CurioDev/CurioBase/BOM.md

# Curio Bill of Materials (BOM)

| # | Component | Est. Cost | Link
|---|---|---| ----
| 1 | MDBT42Q Bluetooth Module | £12 | [Link](https://shop.espruino.com/mdbt42q/mdbt42q-module)
| 2 | Stepper Motors | ~£5 | [Link](https://amzn.eu/d/4aenMIB)
| 3 | LiPo Battery (3.7V, 400mAh) | ~£5 | [Link](https://kitronik.co.uk/products/2209-polymer-lithium-ion-battery-37v-400mah)
| 4 | Body / Wheels | ~£15 |
| 5 | Wires / Screws / Hardware | ~£3 |

---

### 💷 Estimated Total Cost is **£40**
