CurioDev/CurioBase/v1/notes.txt

3mm birch laser ply (poplar isn't strong enough)
Wheels: FS-90RW-C001 / https://www.rapidonline.com/feetech-wheel-for-use-with-fs90r-servo-servo-not-included-37-1338
Steppers: 28BYJ-48
JST cable
9V battery clip

Recent requests
---------------

Move battery bolt hole inwards to align
X Needs to go faster
X Put degree markings on the rotation points
X Put A/B/C markings on the rotation points. All markings to be on the inside to people can put stickers/customize the outside. Let's do:
  A for 0° (Vertical)
  B for 20° (5th crank)
  C for 45° (10th crank)
  D for 65° (14th crank)
  E for 90° (horizontal)
X Have only bottom and top tabs, which are single indents.
X Add another 10mm to the width
X Move battery to middle, hold in place with zip tie
X Make battery charge side hole generously big so most sorts of "USB cable head" can fit in. 
X Make handles adjusting the reclining position more visible (stick out more, colour them red)
X Raise the phone holder up a little (floor clearance + lying flat) - 5mm higher, 3mm forward
X Put perspex circle around the phone holder pivots to strengthen them
X Ensure there's clearance to get the phone 100% vertical
X On/Off button on board + LED indication
X Hiding cables and control board/PCB
X 90mm max phone width
X phone held in with elastic bands
X custom driver board

Mk.1 notes
-----------

FIXED - Wheel cutout needs to be ~4.8 x 2.7mm 
FIXED - Stepper wheels too small - wires touch the ground
FIXED - Stepper wheels really need rubber/something - so either use rubber wheels or o-ring+3x sheets of ply
FIXED - cutout on faceplate for camera?
Do the sides flex too much? Do they need an elastic band or some kind of support?

Mk. 2 notes
-----------

FIXED Can we get it properly 90 degrees? Move/take down the baseplate by 1mm
FIXED 0.5mm less travel for the bendy clip in the phone holder - can stretch it too far
FIXED Strengthen clip - maybe make it longer, make solid part at end bigger
FIXED Phone holder could be a bit less wide at the bottom to make the rubber band easier to access
