CurioDev/CurioBase/v2/gen/bot.stl

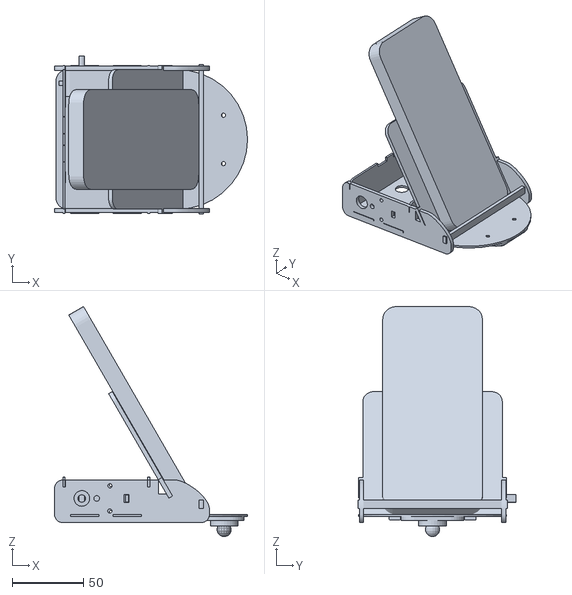
[picture p1: CAD file, 2024-03-22]
v2/gen/bot.stl
135.7 x 111.2 x 161.6
