CurioDev/CurioBase/v2/objs/wheel.stl

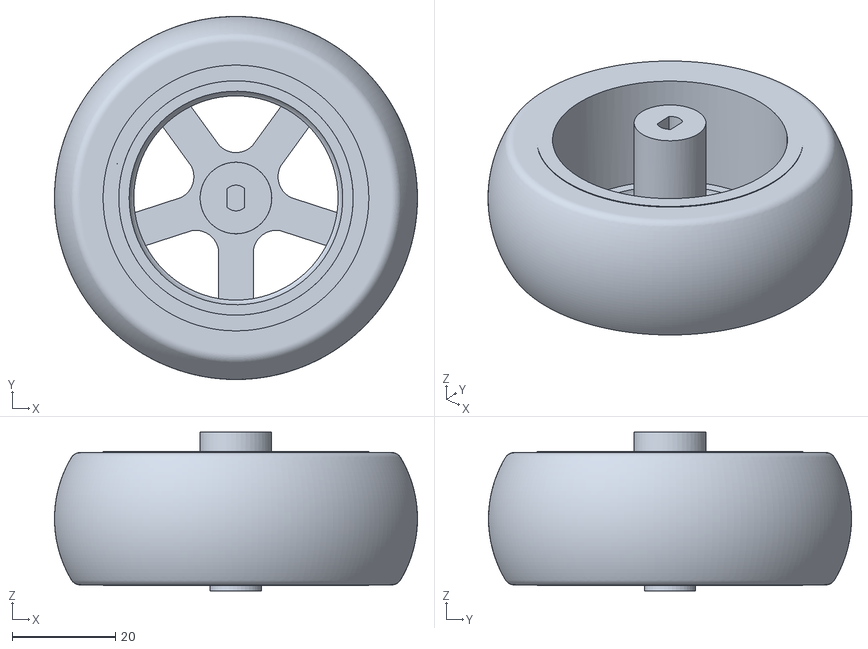
[picture p2: CAD file, 2024-03-22]
v2/objs/wheel.stl
70.5 x 70.5 x 30.8
