CurioDev/CurioBase/v2/objs/motor-tt.stl

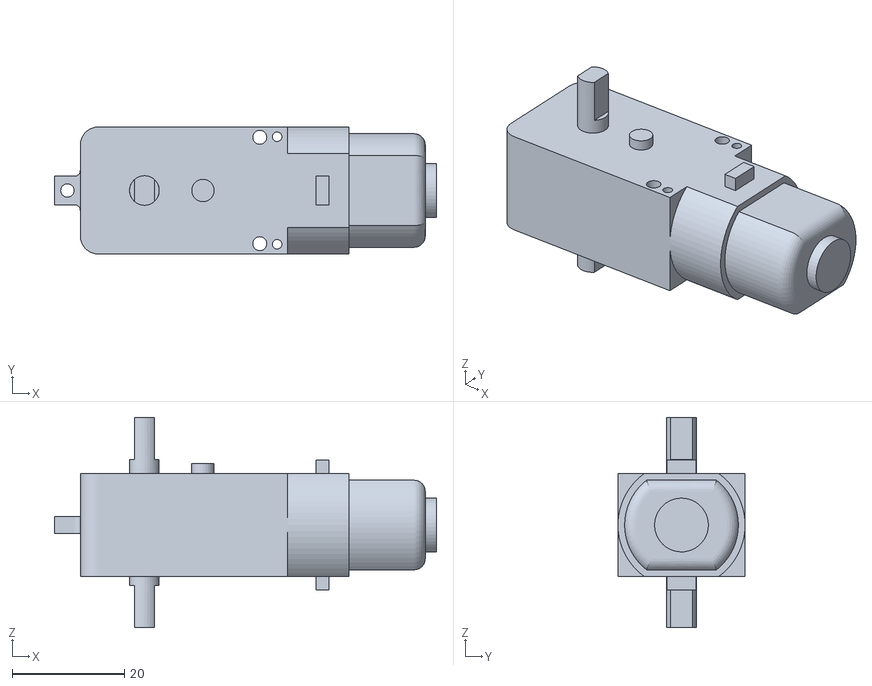
[picture p3: CAD file, 2024-03-22]
v2/objs/motor-tt.stl
68.2 x 22.7 x 37.5
