CurioDev/CurioBase/v1/bot_complete_acrylic.dxf

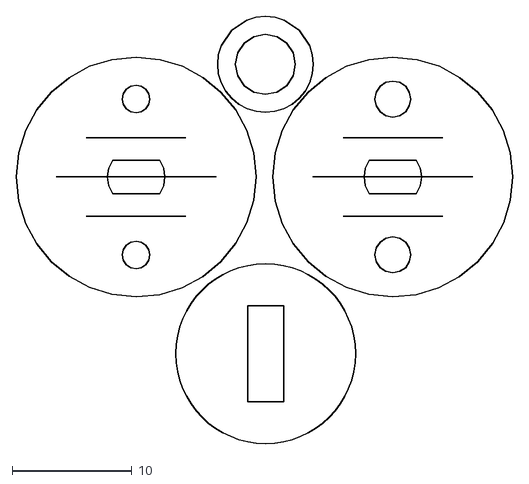
[picture p4: CAD file, 2024-03-22, an earlier design]
v1/bot_complete_acrylic.dxf
41.4 x 35.6
