CurioDev/CurioBase/v1/bot_complete_wood_mod.dxf

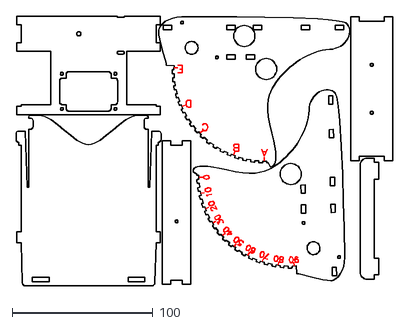
[picture p5: CAD file, 2024-03-22, an earlier design]
v1/bot_complete_wood_mod.dxf
267.6 x 191.5
