CurioDev/CurioBase/v1/bot_complete_wood.dxf

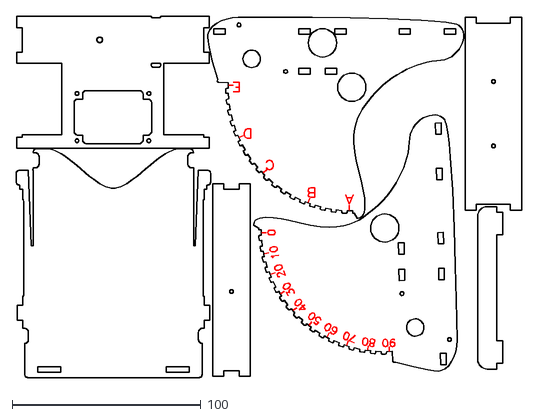
[picture p6: CAD file, 2024-03-22, an earlier design]
v1/bot_complete_wood.dxf
267.7 x 191.4
