CurioDev/CurioBase/v1/bot_wheel_mount.dxf

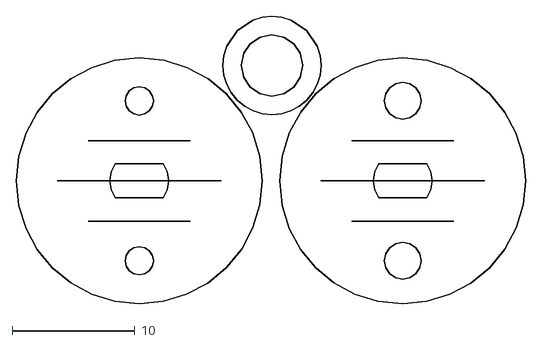
[picture p7: CAD file, 2024-03-22, an earlier design]
v1/bot_wheel_mount.dxf
41.4 x 23.4
