CurioDev/CurioBase/v1/gen/bot_flat.stl

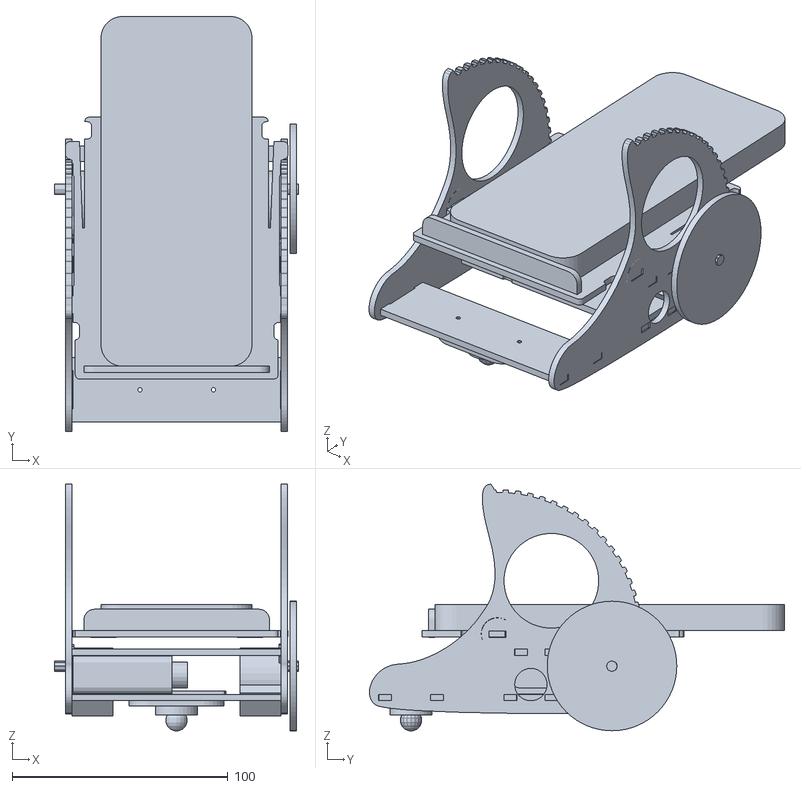
[picture p8: CAD file, 2023-06-23, an earlier design]
v1/gen/bot_flat.stl
113.0 x 192.3 x 114.2
