CurioDev/CurioBase/v1/gen/bot_angled.stl

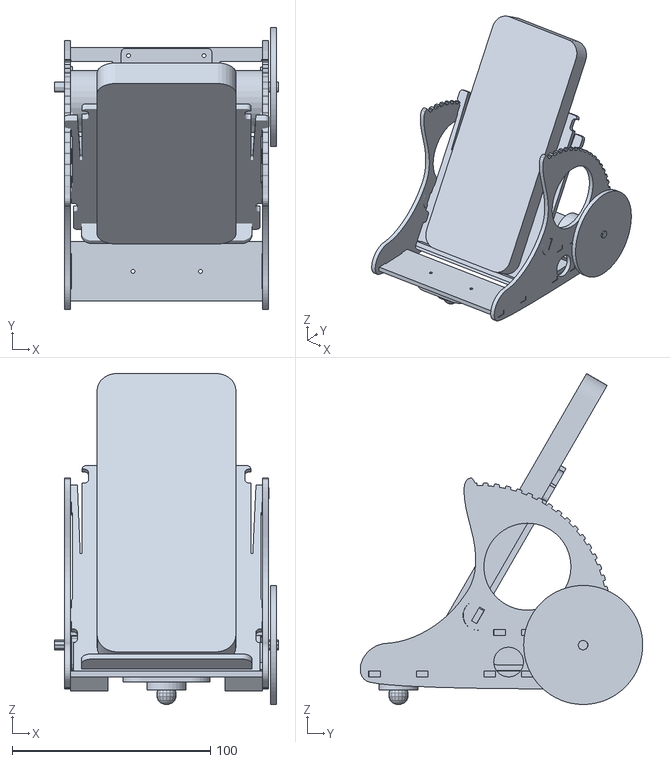
[picture p9: CAD file, 2023-06-23, an earlier design]
v1/gen/bot_angled.stl
113.0 x 142.4 x 166.8
