CurioDev/CurioBase/v1/gen/bot_upright.stl

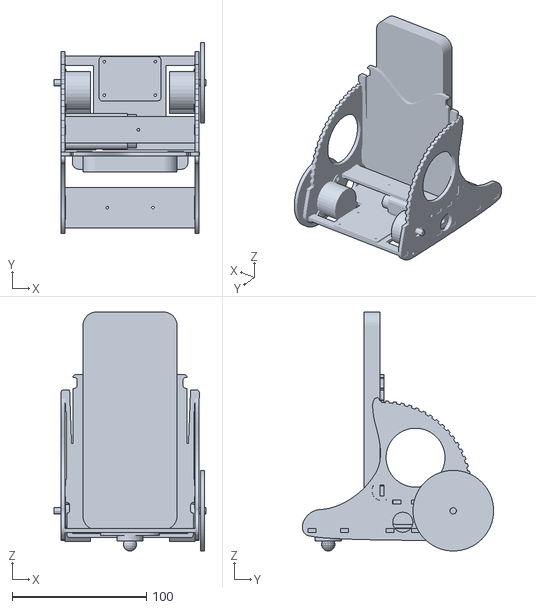
[picture p10: CAD file, 2023-06-23, an earlier design]
v1/gen/bot_upright.stl
113.0 x 142.4 x 177.9
