CurioDev/CurioBase/v1/bot_castorholder.dxf

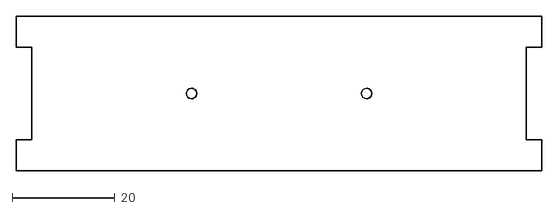
[picture p11: CAD file, 2024-03-22, an earlier design]
v1/bot_castorholder.dxf
102.0 x 30.0
