CurioDev/CurioBase/v1/bot_side.dxf

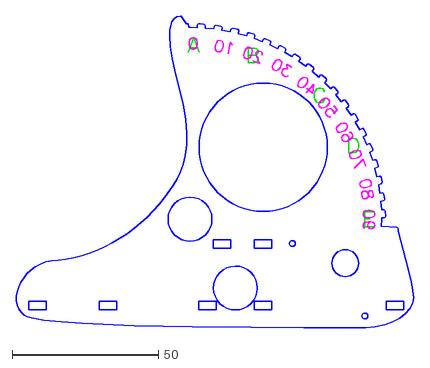
[picture p12: CAD file, 2023-05-22, an earlier design]
v1/bot_side.dxf
135.6 x 106.3
