CurioDev/CurioBase/v1/bot_baseplate.dxf

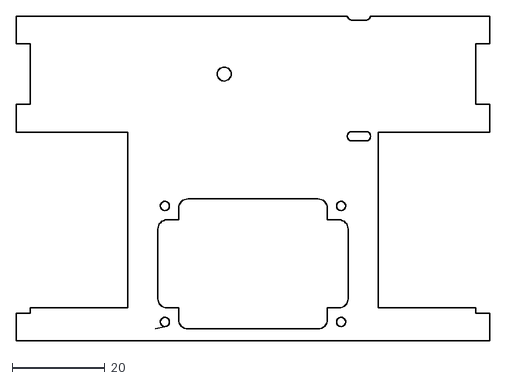
[picture p13: CAD file, 2023-05-22, an earlier design]
v1/bot_baseplate.dxf
102.0 x 70.0
