CurioDev/CurioBase/v1/bot_topplate.dxf

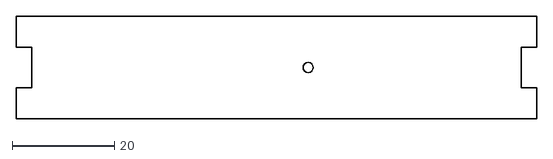
[picture p14: CAD file, 2023-05-22, an earlier design]
v1/bot_topplate.dxf
102.0 x 20.0
