CurioDev/CurioBase/v1/bot_phoneholder.dxf

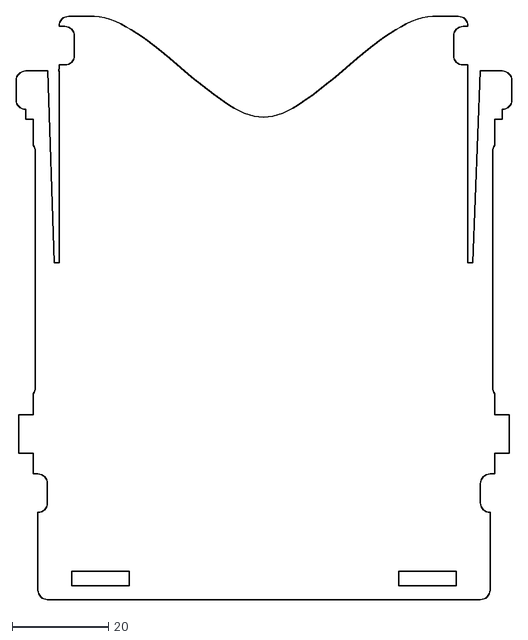
[picture p15: CAD file, 2023-05-22, an earlier design]
v1/bot_phoneholder.dxf
103.0 x 121.2
