CurioDev/CurioBase/v1/bot_phonebase.dxf

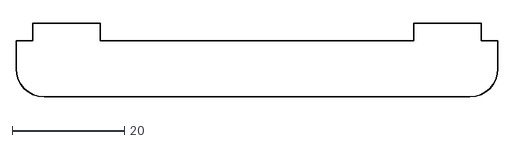
[picture p16: CAD file, 2023-05-03, an earlier design]
v1/bot_phonebase.dxf
86.0 x 13.1
