CurioDev/CurioBase/v1/bot_phone_axle.dxf

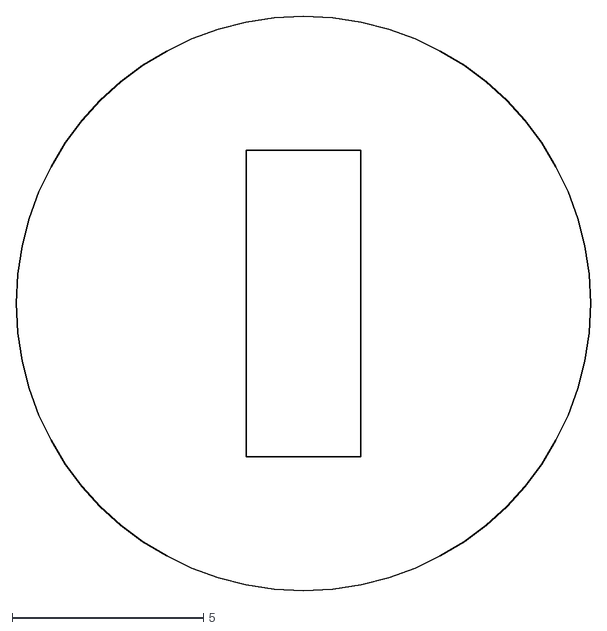
[picture p17: CAD file, 2023-03-31, an earlier design]
v1/bot_phone_axle.dxf
15.0 x 15.0
