CurioDev/CurioBase/v1/bot_wheel.dxf

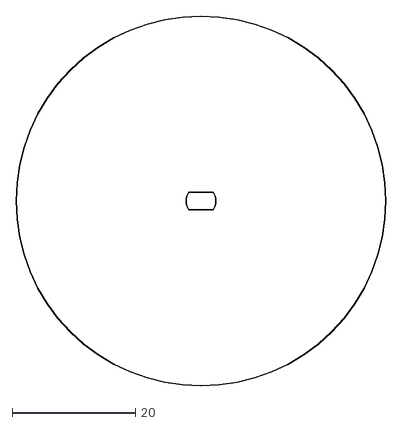
[picture p18: CAD file, 2023-02-08, an earlier design]
v1/bot_wheel.dxf
60.0 x 60.0
