CurioDev/CurioBase/(list of files, cad)

Other CAD files:
v1/bot.scad
