CurioDev/CurioBase/v2/sch/bot_base.brd

## EAGLE design v2/sch/bot_base.brd (2024-07-25)

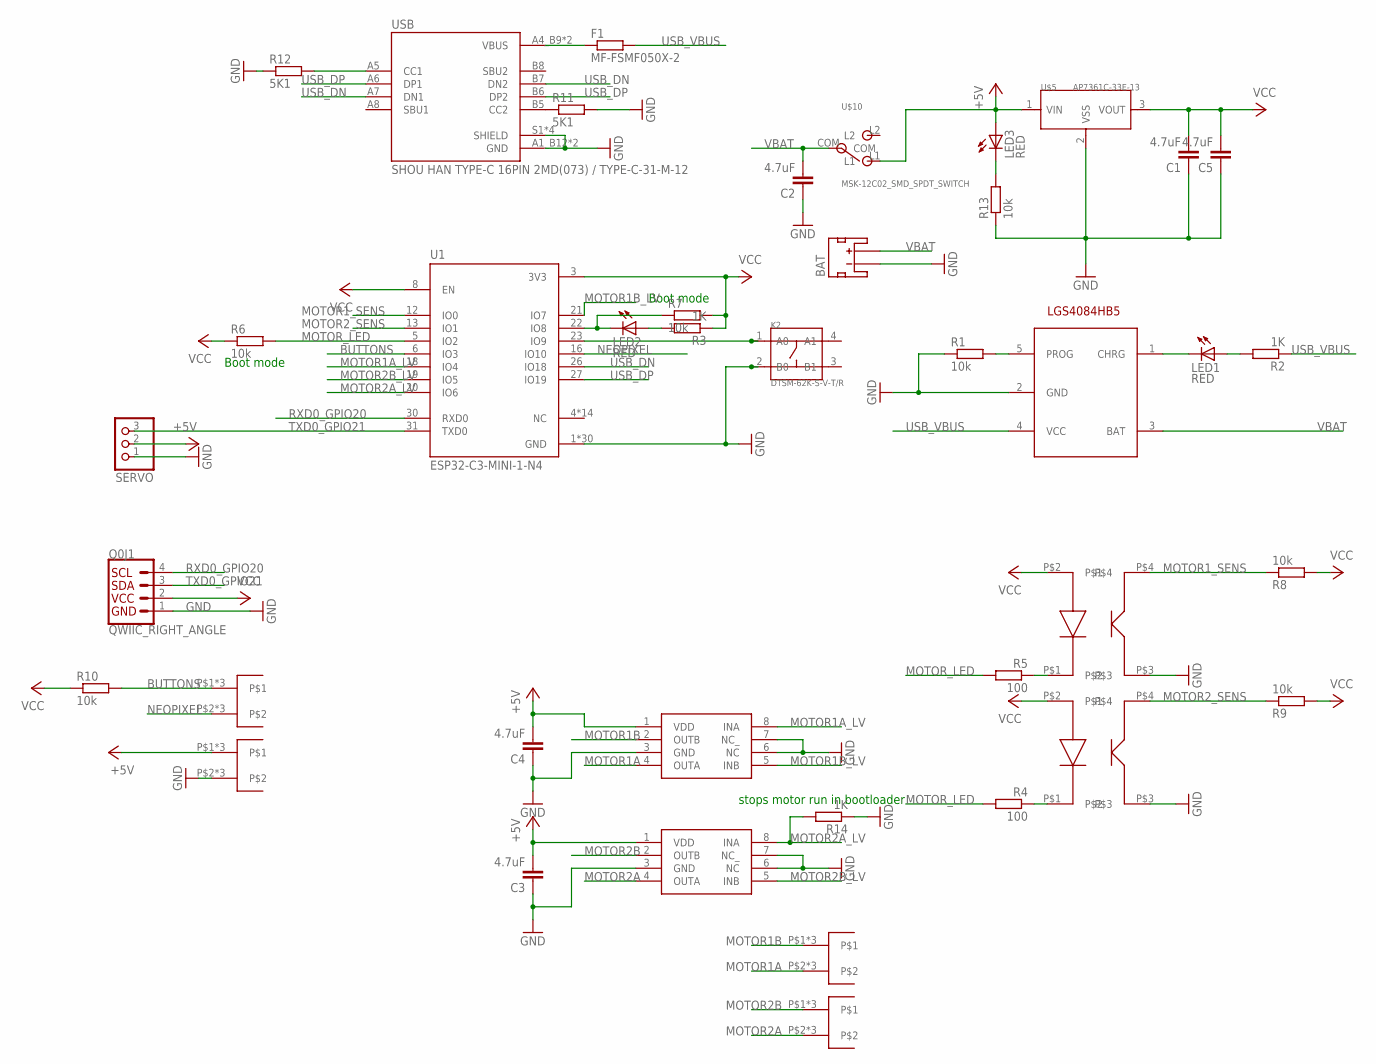
[picture p19: schematic bot_base.sch]

Parts:
BAT: C47647 / S2B-PH-SM4-TB; JST-2-SMD
C1, C2, C3, C4, C5: 4.7uF; C0805
F1: MF-FSMF050X-2; R0603
K2: DTSM-62K-S-V-T/R; SW4-SMD-6.0X6.0X5.0MM
LED1, LED2, LED3: RED; CHIPLED_0603
Q0: QWIIC_RIGHT_ANGLE; JST04_1MM_RA
R1, R6, R7, R8, R9, R10, R13: 10k; R0603
R2, R3, R14: 1K; R0603
R4, R5: 100; R0603
R11, R12: 5K1; R0603
SERVO: PINHD-1X03_2.54-S; 1X03-S
U1: ESP32-C3-MINI-1-N4; XCVR_ESP32-C3-MINI-1-N4
U4: LGS4084HB5; SOT23-5
U$1, U$2: XL-ITR9707
U$3, U$4: GR6205; SOP8
U$5: AP7361C-33E-13; SOT223
U$6, U$7, U$8, U$9: PCBSIDE2
U$10: MSK-12C02_SMD_SPDT_SWITCH; MSK-12C02
USB: SHOU HAN TYPE-C 16PIN 2MD(073) / TYPE-C-31-M-12; HRO_TYPE-C-31-M-12

Connections:
+5V: C3.2, C4.2, LED3.A, SERVO.2, U$3.1 (VDD), U$4.1 (VDD), U$5.1 (VIN), U$9.P$1, U$9.P$3, U$9.P$4, U$10.L1
BOOT: K2.1 (A0), U1.23 (IO9)
BUTTONS: R10.2, U1.6 (IO3), U$8.P$1, U$8.P$3, U$8.P$4
GND: BAT.1 (-), C1.1, C2.1, C3.1, C4.1, C5.1, K2.2 (B0), Q0.1, R1.1, R11.2, R12.1, R13.1, R14.1, SERVO.1, U1.1 (GND), U1.2 (GND), U1.11 (GND), U1.14 (GND), U1.36 (GND), U1.37 (GND), U1.38 (GND), U1.39 (GND), U1.40 (GND), U1.41 (GND), U1.42 (GND), U1.43 (GND), U1.44 (GND), U1.45 (GND), U1.46 (GND), U1.47 (GND), U1.48 (GND), U1.49_1 (GND), U1.49_2 (GND), U1.49_3 (GND), U1.49_4 (GND), U1.49_5 (GND), U1.49_6 (GND), U1.49_7 (GND), U1.49_8 (GND), U1.49_9 (GND), U1.50 (GND), U1.51 (GND), U1.52 (GND), U1.53 (GND), U4.2 (GND), U$1.P$3, U$2.P$3, U$3.3 (GND), U$3.6 (NC), U$3.7 (NC_), U$4.3 (GND), U$4.6 (NC), U$4.7 (NC_), U$5.2 (VSS), U$9.P$2, U$9.P$5, U$9.P$6, USB.A1_B12 (GND), USB.B1_A12 (GND), USB.S1 (SHIELD), USB.S2 (SHIELD), USB.S3 (SHIELD), USB.S4 (SHIELD)
MOTOR1A: U$3.4 (OUTA), U$6.P$2, U$6.P$5, U$6.P$6
MOTOR1A_LV: U1.18 (IO4), U$3.8 (INA)
MOTOR1B: U$3.2 (OUTB), U$6.P$1, U$6.P$3, U$6.P$4
MOTOR1B_LV: U1.21 (IO7), U$3.5 (INB)
MOTOR1_SENS: R8.1, U1.12 (IO0), U$1.P$4
MOTOR2A: U$4.4 (OUTA), U$7.P$2, U$7.P$5, U$7.P$6
MOTOR2A_LV: R14.2, U1.20 (IO6), U$4.8 (INA)
MOTOR2B: U$4.2 (OUTB), U$7.P$1, U$7.P$3, U$7.P$4
MOTOR2B_LV: U1.19 (IO5), U$4.5 (INB)
MOTOR2_SENS: R9.1, U1.13 (IO1), U$2.P$4
MOTOR_LED: R4.2, R5.2, R6.2, U1.5 (IO2)
unnamed: LED1.C, U4.1 (CHRG)
unnamed: LED3.C, R13.2
unnamed: R5.1, U$1.P$1
unnamed: LED1.A, R2.2
unnamed: R4.1, U$2.P$1
unnamed: LED2.A, R3.2
unnamed: R11.1, USB.B5 (CC2)
unnamed: LED2.C, R7.1, U1.22 (IO8)
unnamed: R12.2, USB.A5 (CC1)
unnamed: R1.2, U4.5 (PROG)
NEOPIXEL: U1.16 (IO10), U$8.P$2, U$8.P$5, U$8.P$6
RXD0_GPIO20: Q0.4, U1.30 (RXD0)
TXD0_GPIO21: Q0.3, SERVO.3, U1.31 (TXD0)
USB_DN: U1.26 (IO18), USB.A7 (DN1), USB.B7 (DN2)
USB_DP: U1.27 (IO19), USB.A6 (DP1), USB.B6 (DP2)
USB_VBUS: F1.2, R2.1, U4.4 (VCC)
VBAT: BAT.2 (+), C2.2, U4.3 (BAT), U$10.COM
VBUS1: F1.1, USB.A4_B9 (VBUS), USB.B4_A9 (VBUS)
VCC: C1.2, C5.2, Q0.2, R3.1, R6.1, R7.2, R8.2, R9.2, R10.1, U1.3 (3V3), U1.8 (EN), U$1.P$2, U$2.P$2, U$5.3 (VOUT)

Notes on the sheet:
LGS4084HB5
Boot mode
stops motor run in bootloader

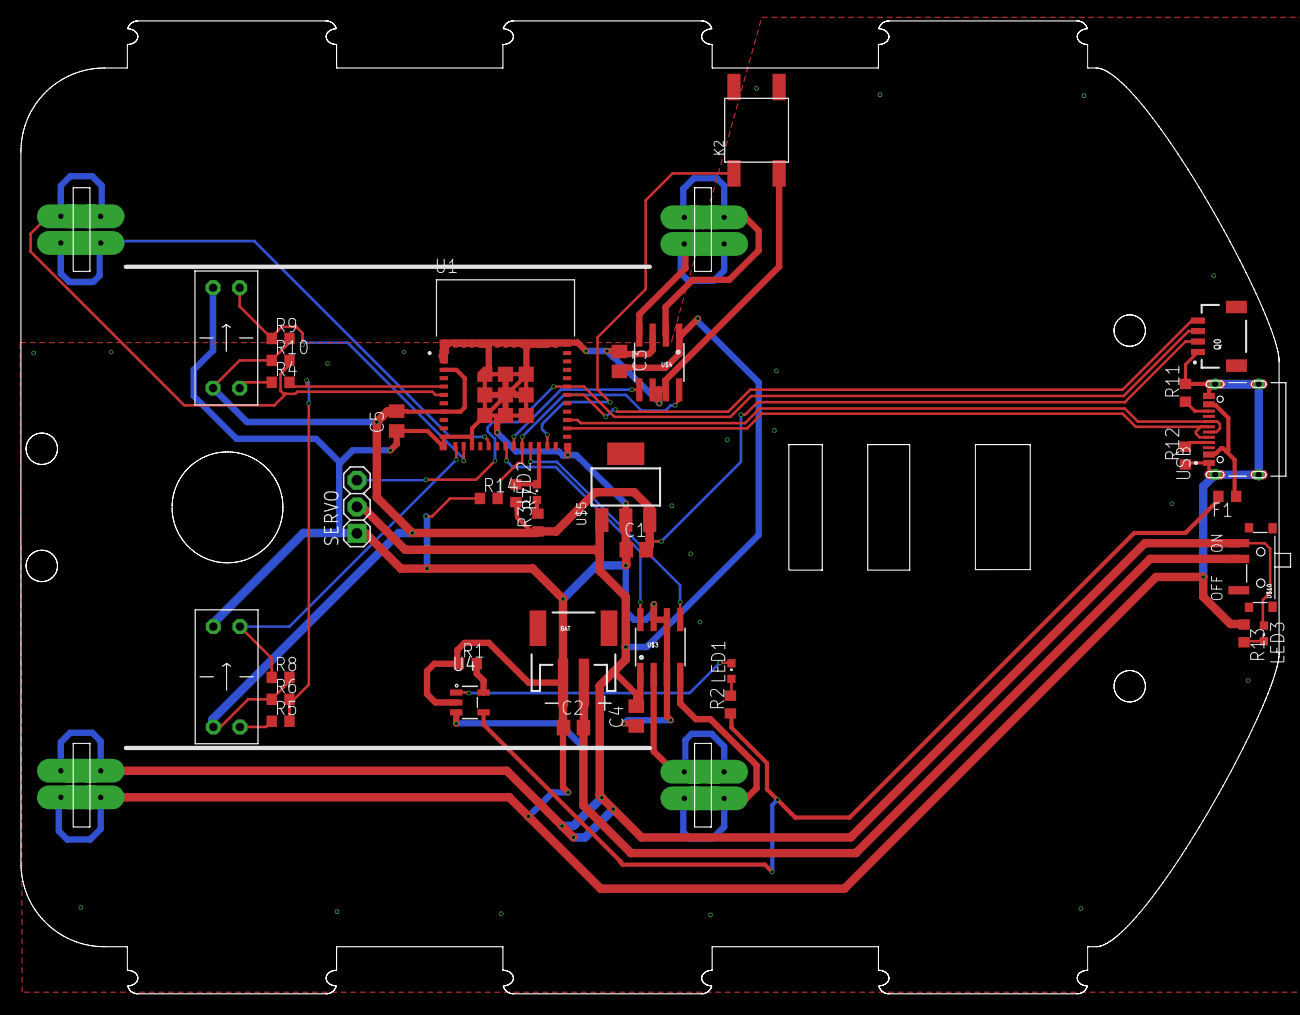
[picture p20: board bot_base.brd from above]

Board: 2 copper layers, 120.3 x 93.0 mm, 40 parts (0 on the bottom side), 34 nets.
