CurioDev/CurioBase/v2/sch/motor_front.brd

## EAGLE design v2/sch/motor_front.brd (2024-07-22)

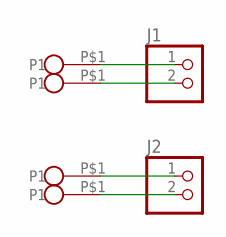
[picture p21: schematic motor_front.sch]

Parts:
J1, J2: PINHD-1X2; 1X02
U$1, U$2, U$3, U$4: BIGHOLE

Connections:
unnamed: J1.1, U$1.P$1
unnamed: J1.2, U$2.P$1
unnamed: J2.1, U$4.P$1
unnamed: J2.2, U$3.P$1

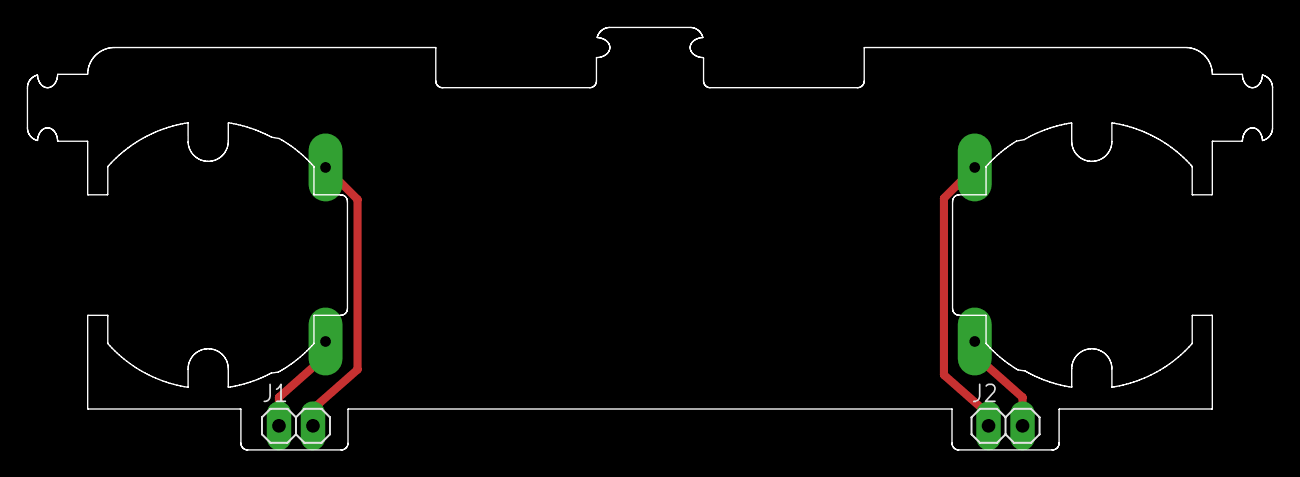
[picture p22: board motor_front.brd from above]

Board: 2 copper layers, 93.0 x 31.6 mm, 6 parts (0 on the bottom side), 4 nets.
