CurioDev/CurioBase/v2/sch/motor_back.brd

## EAGLE design v2/sch/motor_back.brd (2024-06-12)

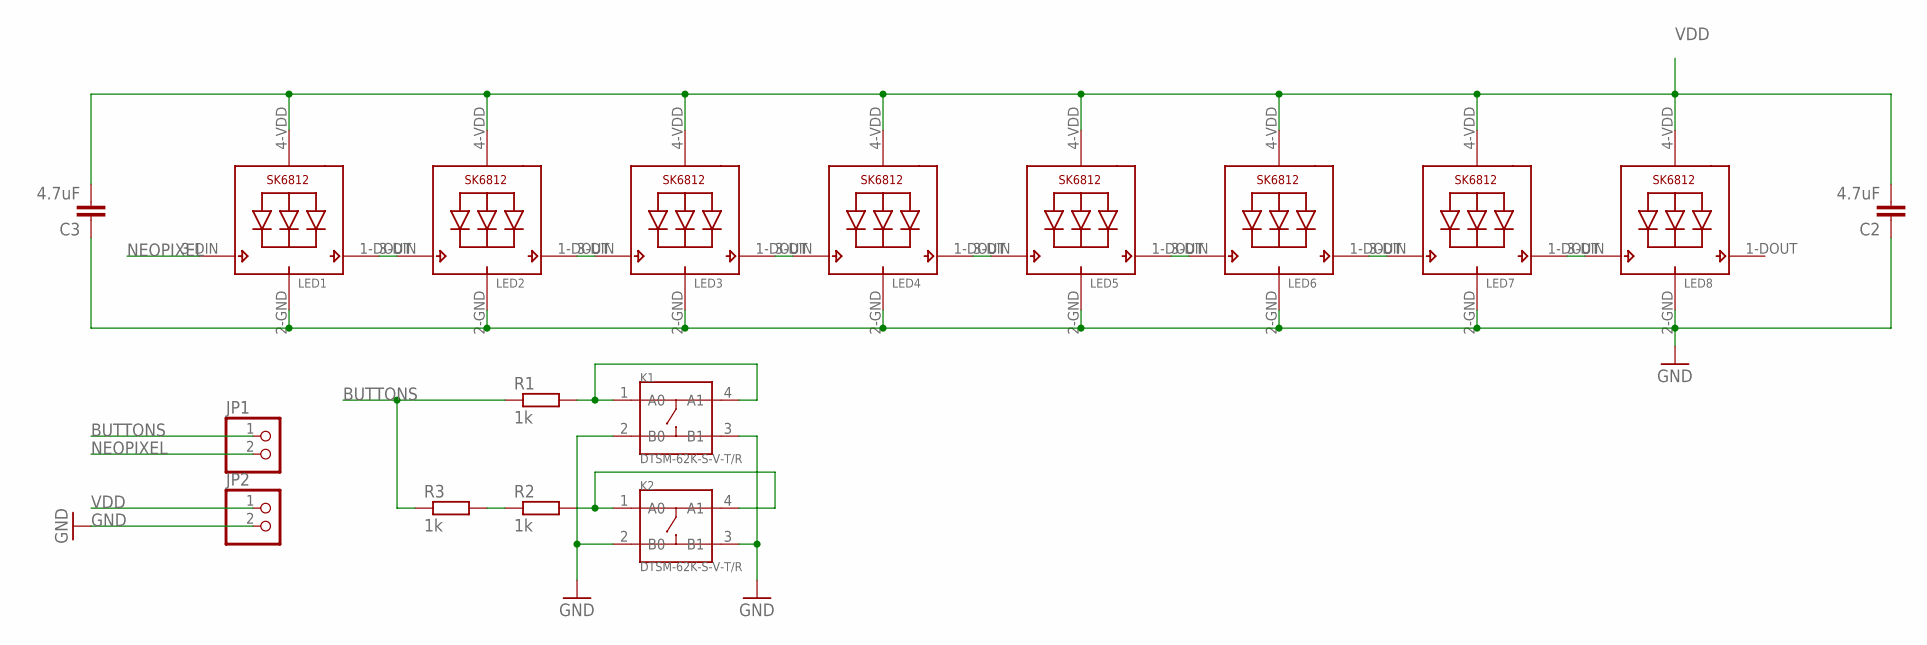
[picture p23: schematic motor_back.sch]

Parts:
C2, C3: 4.7uF; C0805
JP1, JP2: PINHD-1X2; 1X02
K1, K2: DTSM-62K-S-V-T/R; SW4-SMD-6.0X6.0X5.0MM
LED1, LED2, LED3, LED4, LED5, LED6, LED7, LED8: SK6812_3535; LED3535
R1, R2, R3: 1k; R0603

Connections:
BUTTONS: JP1.1, R1.1, R3.1
GND: C2.1, C3.1, JP2.2, K1.2 (B0), K1.3 (B1), K2.2 (B0), K2.3 (B1), LED1.2-GND (GND), LED2.2-GND (GND), LED3.2-GND (GND), LED4.2-GND (GND), LED5.2-GND (GND), LED6.2-GND (GND), LED7.2-GND (GND), LED8.2-GND (GND)
unnamed: LED1.1-DOUT (DO), LED2.3-DIN (DI)
unnamed: LED2.1-DOUT (DO), LED3.3-DIN (DI)
unnamed: LED3.1-DOUT (DO), LED4.3-DIN (DI)
unnamed: LED4.1-DOUT (DO), LED5.3-DIN (DI)
unnamed: LED5.1-DOUT (DO), LED6.3-DIN (DI)
unnamed: LED6.1-DOUT (DO), LED7.3-DIN (DI)
unnamed: LED7.1-DOUT (DO), LED8.3-DIN (DI)
unnamed: K1.1 (A0), K1.4 (A1), R1.2
unnamed: K2.1 (A0), K2.4 (A1), R2.2
unnamed: R2.1, R3.2
NEOPIXEL: JP1.2, LED1.3-DIN (DI)
VDD: C2.2, C3.2, JP2.1, LED1.4-VDD (VDD), LED2.4-VDD (VDD), LED3.4-VDD (VDD), LED4.4-VDD (VDD), LED5.4-VDD (VDD), LED6.4-VDD (VDD), LED7.4-VDD (VDD), LED8.4-VDD (VDD)

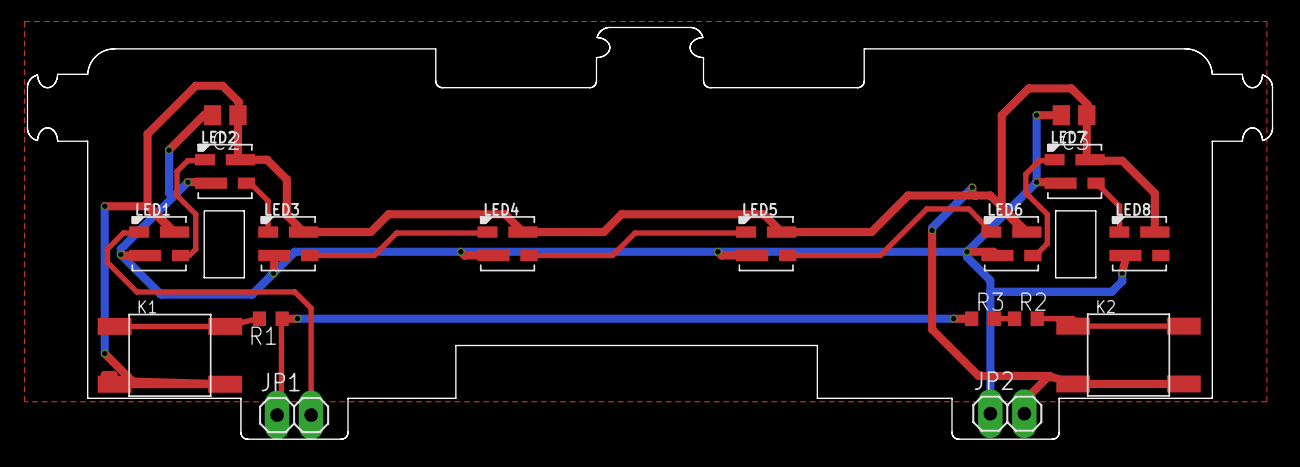
[picture p24: board motor_back.brd from above]

Board: 2 copper layers, 93.0 x 30.8 mm, 17 parts (0 on the bottom side), 14 nets.
