CurioDev/CurioBase/(commit log)

2022-11-30 Initial ideas
    [bot.dxf, bot.scad, bot.stl]
2023-01-11 building bot up - it's easier to have separate DXF for each part
    [bot.scad, bot_phoneholder.dxf, bot_side.dxf, bot_wheel.dxf]
2023-01-12 split up bot parts
    [bot.dxf, bot.scad, bot_castorholder.dxf]
2023-01-12 tweaked design, allowing almost flat
    [bot.scad, bot.stl, bot_angled.stl, bot_phonebase.dxf, bot_side.dxf, bot_upright.stl]
2023-01-12 widened robot to allow elastic over wider phones
    [bot.scad, bot_angled.stl, bot_castorholder.dxf, bot_flat.stl, bot_phonebase.dxf, bot_phoneholder.dxf, bot_side.dxf, bot_upright.stl]
2023-02-08 slightly more complete design
    [bot.scad, bot_baseplate.dxf, bot_complete.dxf, bot_phoneholder.dxf, bot_side.dxf]
2023-02-08 mk 1
    [bot_side.dxf, bot_wheel.dxf, bot_wheel_mount.dxf]
2023-03-30 adding battery and PCB
    [bot.scad]
2023-03-31 recent updates
    [bot.scad, bot_baseplate.dxf, bot_phone_axle.dxf, bot_phoneholder.dxf, bot_side.dxf, bot_topplate.dxf]
2023-03-31 remove phone clips, put indents for rubber bands
    [bot_angled.stl, bot_baseplate.dxf, bot_flat.stl, bot_phoneholder.dxf, bot_upright.stl]
2023-04-03 shrink phone holder elastic band clip
    [bot_baseplate.dxf, bot_phoneholder.dxf]
2023-04-19 generated files
    [bot.scad, bot_angled.stl, bot_flat.stl, bot_upright.stl]
2023-04-19 adding angle markings on sides
    [bot_side.dxf]
2023-04-19 widen slots for phone alignment and round edges
    [bot_side.dxf]
2023-05-03 update phone base svg
    [bot_complete.dxf, bot_complete_acrylic.dxf, bot_complete_wood.dxf, bot_phonebase.dxf]
2023-05-22 most recent tweaks
    [bot_baseplate.dxf, bot_phoneholder.dxf, bot_side.dxf, bot_topplate.dxf]
2023-06-23 Updated with new side panels and updated phone holder
    [bot_angled.stl, bot_complete_wood.dxf, bot_flat.stl, bot_upright.stl]
2024-03-22 move v1
    [bot.scad, bot_angled.stl, bot_baseplate.dxf, bot_castorholder.dxf, bot_complete_acrylic.dxf, bot_complete_wood.dxf, bot_complete_wood_mod.dxf, bot_flat.stl]
2024-03-22 first v2 attempt
    [bot.scad, bot.stl, motor-tt.stl, wheel.stl]
2024-03-22 add something to stop the phone slipping
    [bot.scad, bot.stl]
2024-03-27 assembled in real life and mostly ok
    [bot.scad]
2024-04-24 Updated design with 10/25/40 phone angles and elastic bang grips
    [bot.scad]
2024-05-17 initial schematics
    [bot_base.brd, bot_base.sch, motor_back.brd, motor_back.sch, motor_front.brd, motor_front.sch]
2024-05-21 routing almost finished
    [bot_base.brd, bot_base.sch, motor_back.brd, motor_back.sch, motor_front.brd]
2024-05-24 first protos sent off
    [bot_base.brd]
2024-05-24 switch update
    [bot_base.brd, bot_base.sch]
2024-06-12 mid-update, fixing issues
    [bot_base.brd, bot_base.sch, motor_back.brd, motor_front.brd]
2024-06-21 latest relayout
    [bot_base.brd, bot_base.sch]
2024-07-22 add bumpers
    [bot.scad, motor_front.brd]
2024-07-25 update for most recent prototypes
    [bot_base.brd, bot_base.sch]
